Froggy111/ee1111a/pcb/production/bom.csv

Designator | Footprint | Quantity | Value | LCSC Part #
C10, C11, C12, C13, C16, C17, C20, C21, C22, C23, C24, C26, C27, C31, C40, C41, C42, C44, C45, C48, C50, C51, C52, C54, C55, C6, C9 | 0402 | 27 | 100nF 25V | 0402B104K250NT
C14, C32, C36 | CP_Elec_6.3x7.7 | 3 | 220uF 25V
C15, C39, C5, C7 | 0603 | 4 | 1uF 25V | 0603B105M250NT
C18, C19, C2, C25, C28, C29, C30, C33, C35, C37 | 1206 | 10 | 10uF 25V
C34 | 0402 | 1 | 22pF 50V C0G | 0402B104K250NT
C38, C4 | CP_EIA-3216-18_Kemet-A | 2 | 10uF 16V A | CA45-A016K106T
C43, C47, C49 | 0402 | 3 | 2.2uF 6.3V | 0402B104K250NT
C46, C53 | 0402 | 2 | 33pF 50V C0G
D1, D2, D3 | D_SOD-123F | 3 | SMF13CA
D4 | D_SMA | 1 | SS34
D5 | 0402 | 1 | XL-1005SURC | XL-1005SURC
F1, F2 | 1206 | 2 | 4A 15V | BFS1206-4000T/S
FB1, FB2 | 0805 | 2 | 600@100MHz 100m | CBM201209U601T
J1 | AMASS_XT60-M_1x02_P7.20mm_Vertical | 1 | XT60-M
J2 | JST_XH_B4B-XH-A_1x04_P2.50mm_Vertical | 1 | XH_B4B
J3 | Molex_Micro-Fit_3.0_43045-0212_2x01_P3.00mm_Vertical | 1 | 43045-0212
J4 | USB_A_Molex_67643_Horizontal | 1 | USB_A
J5 | PinHeader_1x04_P2.54mm_Vertical | 1 | PinHeader_P2.54_01x04
J6 | USB_C_Receptacle_16P | 1 | USB_C_Receptacle_USB2.0_16P | TYPE-C 16PIN 2MD(073)
L1 | IND-SMD_L13.5-W12.6 | 1 | XR1365-330M
L2 | L_Bourns-SRN6028 | 1 | 3.3uH 4.5A
Q1, Q2, Q3 | SOT-23 | 3 | BSS84K
Q6, Q7 | PDFNWB-8L(3.3x3.3) | 2 | PTQ3060
R1 | 1206 | 1 | 10m 1% 1W
R10, R20, R5 | 0402 | 3 | 36k 5%
R11, R12, R16, R21, R27, R29, R32, R39, R40, R41, R42, R43, R44, R6 | 0402 | 14 | 10k 5%
R13, R14, R2 | 1206 | 3 | 200 1% 250mW | 1206W4F2000T5E
R15, R22, R35, R36, R8 | 0402 | 5 | 2.2k 5%
R17, R18, R19, R3, R4, R7 | 0402 | 6 | 10 5%
R25 | 0402 | 1 | 124k 1%
R26 | 0402 | 1 | 22.1k 1%
R28 | 0402 | 1 | 1kR 1%
R30, R31 | 0402 | 2 | 27 1%
R33, R34 | 0402 | 2 | 1k 1%
R37, R38 | 0402 | 2 | 5.1k 1% | RC-02K512JT
SW1, SW2 | SW_SPST_TS-1088-xR020 | 2 | TS-1088 | TS-1088-AR02016
U1 | SOIC-8_3.9x4.9mm_P1.27mm | 1 | INA219BxD
U2, U5 | Texas_DGN0008G_VSSOP-8-1EP_3x3mm_P0.65mm_EP2x2.94mm_Mask1.846x2.15mm_ThermalVias | 2 | MX27524ES
U3 | SOT-23-5 | 1 | TMI6050-33
U4 | HTSOP-8-1EP_3.9x4.9mm_P1.27mm_EP2.4x3.2mm_ThermalVias | 1 | EA8276P8R
U6 | Winbond_USON-8-1EP_3x2mm_P0.5mm_EP0.2x1.6mm | 1 | W25Q16JVUXIQ
U7 | QFN-56-1EP_7x7mm_P0.4mm_EP3.2x3.2mm | 1 | RP2040
U8 | Diodes_UDFN-10_1x2.5mm_P0.5mm | 1 | ESD73034D-10/TR(ES) | ESD73034D-10/TR(ES)
Y1 | Crystal_SMD_3225-4Pin_3.2x2.5mm | 1 | X322512MSB4SI
