Froggy111/ee1111a/pcb/pcb.kicad_pcb

## KiCad design pcb/pcb.kicad_pcb (2026-10-22)

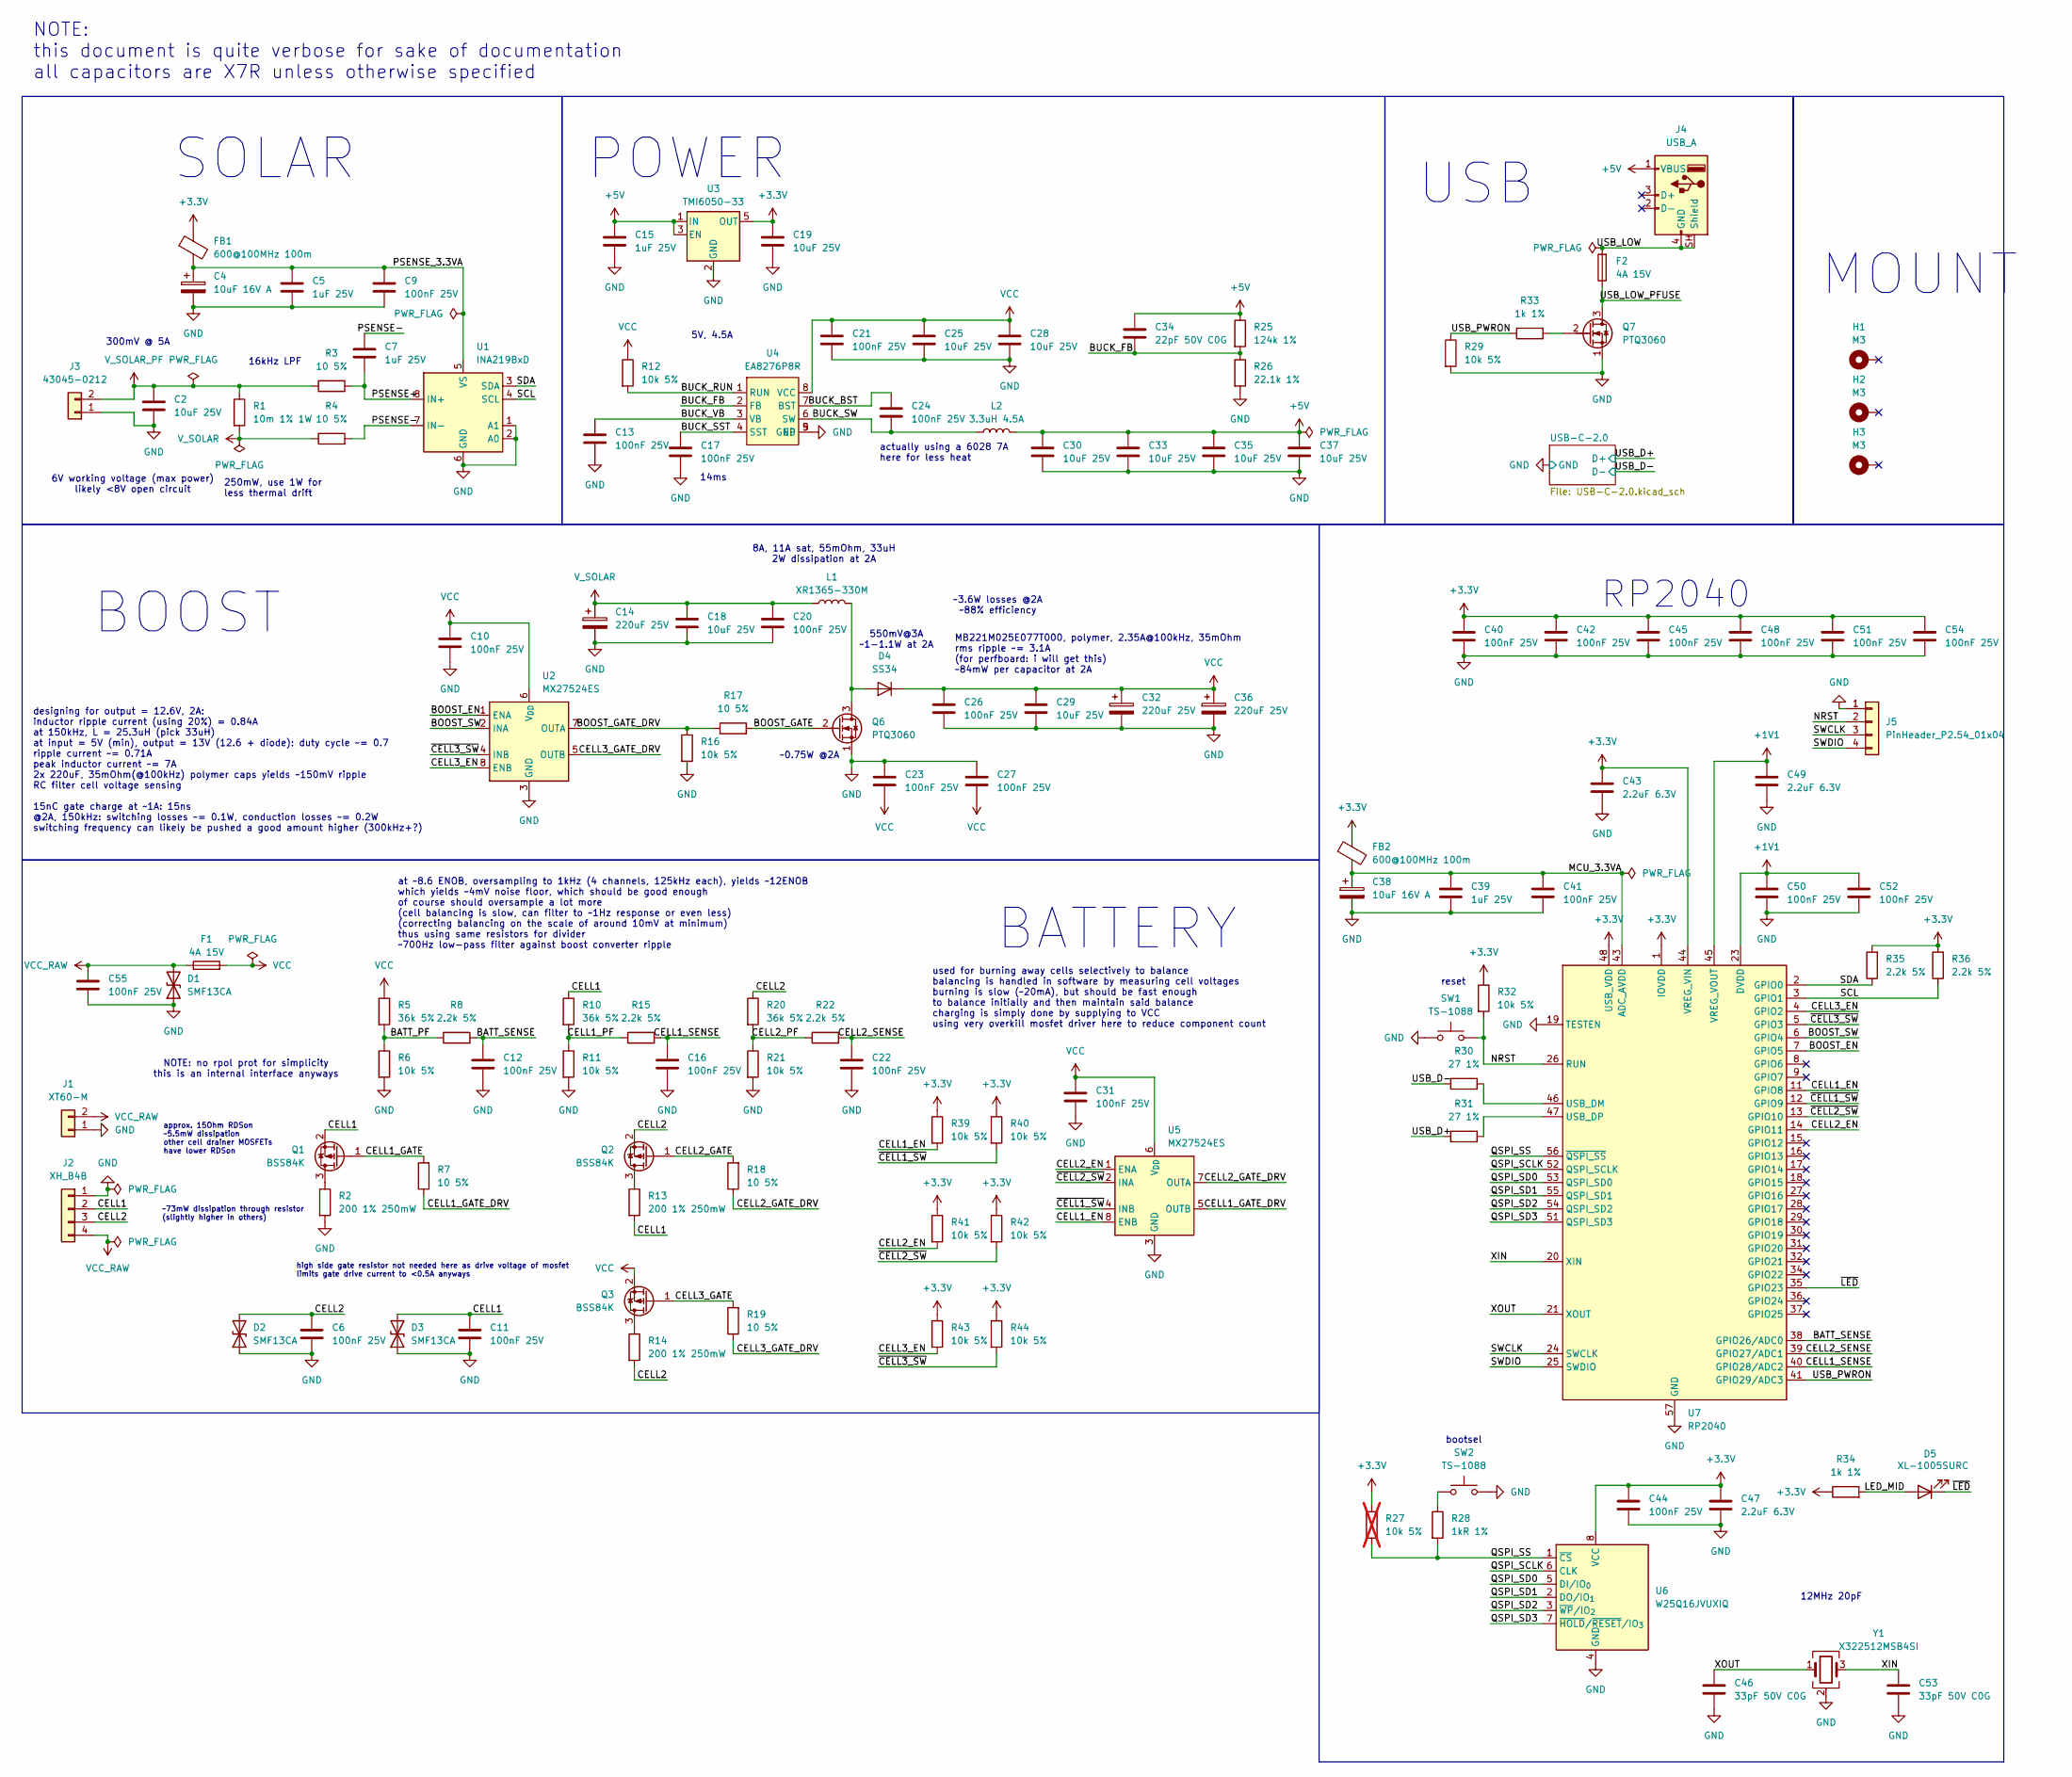
[picture p1: schematic pcb.kicad_sch]

Parts:
C2, C18, C19, C25, C28, C29, C30, C33, C35, C37: 10uF 25V; C_1206_3216Metric
C4, C38: 10uF 16V A; CP_EIA-3216-18_Kemet-A; MPN CA45-A016K106T
C5, C7, C15, C39: 1uF 25V; C_0603_1608Metric; MPN 0603B105M250NT
C6, C9, C10, C11, C12, C13, C16, C17, C20, C21, C22, C23, C24, C26, C27, C31, C40, C41, C42, C44, C45, C48, C50, C51, C52, C54, C55: 100nF 25V; C_0402_1005Metric; MPN 0402B104K250NT
C14, C32, C36: 220uF 25V; CP_Elec_6.3x7.7
C34: 22pF 50V C0G; C_0402_1005Metric; MPN 0402B104K250NT
C43, C47, C49: 2.2uF 6.3V; C_0402_1005Metric; MPN 0402B104K250NT
C46, C53: 33pF 50V C0G; C_0402_1005Metric
D1, D2, D3: SMF13CA; D_SOD-123F
D4: SS34; D_SMA
D5: XL-1005SURC; LED_0402_1005Metric; MPN XL-1005SURC
F1, F2: 4A 15V; Fuse_1206_3216Metric; MPN BFS1206-4000T/S
FB1, FB2: 600@100MHz 100m; L_0805_2012Metric; MPN CBM201209U601T
H1, H2, H3: M3; MountingHole_3.2mm_M3_Pad_Via
J1: XT60-M; AMASS_XT60-M_1x02_P7.20mm_Vertical
J2: XH_B4B; JST_XH_B4B-XH-A_1x04_P2.50mm_Vertical
J3: 43045-0212; Molex_Micro-Fit_3.0_43045-0212_2x01_P3.00mm_Vertical
J4: USB_A; USB_A_Molex_67643_Horizontal
J5: PinHeader_P2.54_01x04; PinHeader_1x04_P2.54mm_Vertical
L1: XR1365-330M; IND-SMD_L13.5-W12.6
L2: 3.3uH 4.5A; L_Bourns-SRN6028
Q1, Q2, Q3: BSS84K; SOT-23
Q6, Q7: PTQ3060; PDFNWB-8L(3.3x3.3)
R1: 10m 1% 1W; R_1206_3216Metric
R2, R13, R14: 200 1% 250mW; R_1206_3216Metric; MPN 1206W4F2000T5E
R3, R4, R7, R17, R18, R19: 10 5%; R_0402_1005Metric
R5, R10, R20: 36k 5%; R_0402_1005Metric
R6, R11, R12, R16, R21, R29, R32, R39, R40, R41, R42, R43, R44: 10k 5%; R_0402_1005Metric
R8, R15, R22, R35, R36: 2.2k 5%; R_0402_1005Metric
R25: 124k 1%; R_0402_1005Metric
R26: 22.1k 1%; R_0402_1005Metric
R27: 10k 5%; R_0402_1005Metric; not fitted
R28: 1kR 1%; R_0402_1005Metric
R30, R31: 27 1%; R_0402_1005Metric
R33, R34: 1k 1%; R_0402_1005Metric
SW1, SW2: TS-1088; SW_SPST_TS-1088-xR020; MPN TS-1088-AR02016
U1: INA219BxD; SOIC-8_3.9x4.9mm_P1.27mm
U2, U5: MX27524ES; Texas_DGN0008G_VSSOP-8-1EP_3x3mm_P0.65mm_EP2x2.94mm_Mask1.8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
U3: TMI6050-33; SOT-23-5
U4: EA8276P8R; HTSOP-8-1EP_3.9x4.9mm_P1.27mm_EP2.4x3.2mm_ThermalVias
U6: W25Q16JVUXIQ; Winbond_USON-8-1EP_3x2mm_P0.5mm_EP0.2x1.6mm
U7: RP2040; QFN-56-1EP_7x7mm_P0.4mm_EP3.2x3.2mm
Y1: X322512MSB4SI; Crystal_SMD_3225-4Pin_3.2x2.5mm

Connections:
+1V1: C49.1, C50.1, C52.1, U7.23 (DVDD), U7.45 (VREG_VOUT), U7.50 (DVDD)
+3.3V: C19.1, C40.1, C42.1, C43.1, C44.1, C45.1, C47.1, C48.1, C51.1, C54.1, FB1.1, FB2.1, R27.1, R32.1, R34.1, R35.2, R36.2, R39.1, R40.1, R41.1, R42.1, R43.1, R44.1, U3.5 (OUT), U6.8 (VCC), U7.1 (IOVDD), U7.10 (IOVDD), U7.22 (IOVDD), U7.33 (IOVDD), U7.42 (IOVDD), U7.44 (VREG_VIN), U7.48 (USB_VDD), U7.49 (IOVDD)
+5V: C15.1, C30.1, C33.1, C34.1, C35.1, C37.1, J4.1 (VBUS), L2.2, R25.1, U3.1 (IN), U3.3 (EN)
/BATT_PF: R5.2, R6.1, R8.1
/BATT_SENSE: C12.1, R8.2, U7.38 (GPIO26/ADC0)
/BOOST_EN: U2.1 (ENA), U7.7 (GPIO5)
/BOOST_GATE: Q6.2 (G), R17.2
/BOOST_GATE_DRV: R16.1, R17.1, U2.7 (OUTA)
/BOOST_SW: U2.2 (INA), U7.6 (GPIO4)
/BUCK_BST: C24.1, U4.7 (BST)
/BUCK_FB: C34.2, R25.2, R26.1, U4.2 (FB)
/BUCK_RUN: R12.2, U4.1 (RUN)
/BUCK_SST: C17.1, U4.4 (SST)
/BUCK_SW: C24.2, L2.1, U4.6 (SW)
/BUCK_VB: C13.1, U4.3 (VB)
/CELL1: C11.1, D3.2 (A2), J2.2, Q1.2 (S), R10.1, R13.2
/CELL1_EN: R39.2, U5.8 (ENB), U7.11 (GPIO8)
/CELL1_GATE: Q1.1 (G), R7.2
/CELL1_GATE_DRV: R7.1, U5.5 (OUTB)
/CELL1_PF: R10.2, R11.1, R15.1
/CELL1_SENSE: C16.1, R15.2, U7.40 (GPIO28/ADC2)
/CELL2: C6.1, D2.2 (A2), J2.3, Q2.2 (S), R14.2, R20.1
/CELL2_EN: R41.2, U5.1 (ENA), U7.14 (GPIO11)
/CELL2_GATE: Q2.1 (G), R18.2
/CELL2_GATE_DRV: R18.1, U5.7 (OUTA)
/CELL2_PF: R20.2, R21.1, R22.1
/CELL2_SENSE: C22.1, R22.2, U7.39 (GPIO27/ADC1)
/CELL3_EN: R43.2, U2.8 (ENB), U7.4 (GPIO2)
/CELL3_GATE: Q3.1 (G), R19.2
/CELL3_GATE_DRV: R19.1, U2.5 (OUTB)
/LED_MID: D5.2 (A), R34.2
/MCU_3.3VA: C38.1, C39.1, C41.1, FB2.2, U7.43 (ADC_AVDD)
/NRST: J5.2, R32.2, SW1.2, U7.26 (RUN)
/PSENSE+: C7.2, R3.2, U1.8 (IN+)
/PSENSE-: C7.1, R4.2, U1.7 (IN-)
/PSENSE_3.3VA: C4.1, C5.1, C9.1, FB1.2, U1.5 (VS)
/QSPI_SCLK: U6.6 (CLK), U7.52 (QSPI_SCLK)
/QSPI_SD0: U6.5 (DI/IO_{0}), U7.53 (QSPI_SD0)
/QSPI_SD1: U6.2 (DO/IO_{1}), U7.55 (QSPI_SD1)
/QSPI_SD2: U6.3 (~WP/IO_{2}), U7.54 (QSPI_SD2)
/QSPI_SD3: U6.7 (~HOLD/~RESET/IO_{3}), U7.51 (QSPI_SD3)
/QSPI_SS: R27.2, R28.2, U6.1 (~CS), U7.56 (~QSPI_SS)
/SCL: R36.1, U1.4 (SCL), U7.3 (GPIO1)
/SDA: R35.1, U1.3 (SDA), U7.2 (GPIO0)
/SWCLK: J5.3, U7.24 (SWCLK)
/SWDIO: J5.4, U7.25 (SWDIO)
/USB_D+: R31.1; also elsewhere on the board
/USB_D-: R30.1; also elsewhere on the board
/USB_LOW: F2.2, J4.4 (GND), J4.SH (Shield)
/USB_LOW_PFUSE: F2.1, Q7.3 (D)
/USB_PWRON: R29.1, R33.1, U7.41 (GPIO29/ADC3)
/XIN: C53.1, U7.20 (XIN), Y1.3
/XOUT: C46.1, U7.21 (XOUT), Y1.1
/~CELL1_SW: R40.2, U5.4 (INB), U7.12 (GPIO9)
/~CELL2_SW: R42.2, U5.2 (INA), U7.13 (GPIO10)
/~CELL3_SW: R44.2, U2.4 (INB), U7.5 (GPIO3)
/~LED: D5.1 (K), U7.35 (GPIO23)
GND: C2.2, C4.2, C5.2, C6.2, C9.2, C10.2, C11.2, C12.2, C13.2, C14.2, C15.2, C16.2, C17.2, C18.2, C19.2, C20.2, C21.2, C22.2, C23.1, C25.2, C26.2, C27.1, C28.2, C29.2, C30.2, C31.2, C32.2, C33.2, C35.2, C36.2, C37.2, C38.2, C39.2, C40.2, C41.2, C42.2, C43.2, C44.2, C45.2, C46.2, C47.2, C48.2, C49.2, C50.2, C51.2, C52.2, C53.2, C54.2, C55.2, D1.1 (A1), D2.1 (A1), D3.1 (A1), J1.1, J2.1, J3.1, J5.1, Q6.1 (S), Q7.1 (S), R2.2, R6.2, R11.2, R16.2, R21.2, R26.2, R29.2, SW1.1, SW2.2, U1.1 (A1), U1.2 (A0), U1.6 (GND), U2.3 (GND), U2.9 (GND), U3.2 (GND), U4.5 (GND), U4.9 (EP), U5.3 (GND), U5.9 (GND), U6.4 (GND), U6.9 (EP), U7.19 (TESTEN), U7.57 (GND), Y1.2 (G), Y1.4 (G); also elsewhere on the board
unnamed: D4.2 (A), L1.2, Q6.3 (D)
unnamed: Q1.3 (D), R2.1
unnamed: Q2.3 (D), R13.1
unnamed: Q3.3 (D), R14.1
unnamed: Q7.2 (G), R33.2
unnamed: R28.1, SW2.1
unnamed: R30.2, U7.46 (USB_DM)
unnamed: R31.2, U7.47 (USB_DP)
VCC: C10.1, C21.1, C23.2, C25.1, C26.1, C27.2, C28.1, C29.1, C31.1, C32.1, C36.1, D4.1 (K), F1.2, Q3.2 (S), R5.1, R12.1, U2.6 (V_{DD}), U4.8 (VCC), U5.6 (V_{DD})
VCC_RAW: C55.1, D1.2 (A2), F1.1, J1.2, J2.4
V_SOLAR: C14.1, C18.1, C20.1, L1.1, R1.2, R4.1
V_SOLAR_PF: C2.1, J3.2, R1.1, R3.1

Notes on the sheet:
actually using a 6028 7A here for less heat
~73mW dissipation through resistor (slightly higher in others)
POWER
300mV @ 5A
designing for output = 12.6V, 2A: inductor ripple current (using 20%) = 0.84A at 150kHz, L = 25.3uH (pick 33uH) at input = 5V (min), output = 13V (12.6 + diode): duty cycle ~= 0.7 ripple current ~= 0.71A peak inductor current ~= 7A 2x 220uF, 35mOhm(@100kHz) polymer caps yields ~150mV ripple RC filt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
NOTE: this document is quite verbose for sake of documentation all capacitors are X7R unless otherwise specified
SOLAR
14ms
~3.6W losses @2A ~88% efficiency
12MHz 20pF
NOTE: no rpol prot for simplicity this is an internal interface anyways
at ~8.6 ENOB, oversampling to 1kHz (4 channels, 125kHz each), yields ~12ENOB which yields ~4mV noise floor, which should be good enough of course should oversample a lot more (cell balancing is slow, can filter to ~1Hz response or even less) (correcting balancing on the scale of around 10mV at mini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
~0.75W @2A
16kHz LPF
250mW, use 1W for less thermal drift
RP2040
MOUNT
550mV@3A ~1-1.1W at 2A
6V working voltage (max power) likely <8V open circuit
8A, 11A sat, 55mOhm, 33uH 2W dissipation at 2A
BOOST
MB221M025E077T000, polymer, 2.35A@100kHz, 35mOhm rms ripple ~= 3.1A (for perfboard: i will get this) ~84mW per capacitor at 2A
5V, 4.5A
reset
approx. 15Ohm RDSon ~5.5mW dissipation other cell drainer MOSFETs have lower RDSon
high side gate resistor not needed here as drive voltage of mosfet limits gate drive current to <0.5A anyways
bootsel
BATTERY
USB
used for burning away cells selectively to balance balancing is handled in software by measuring cell voltages burning is slow (~20mA), but should be fast enough to balance initially and then maintain said balance charging is simply done by supplying to VCC using very overkill mosfet driver here to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

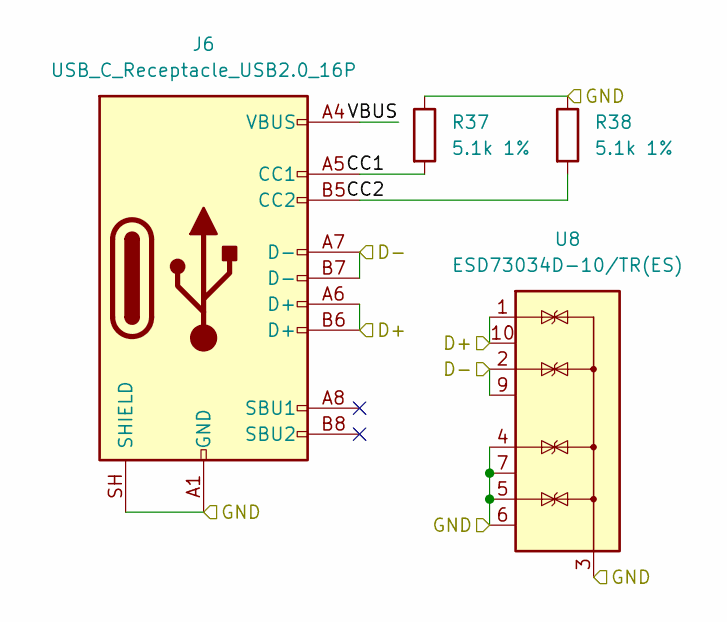
[picture p2: schematic USB-C-2.0.kicad_sch]

Parts:
J6: USB_C_Receptacle_USB2.0_16P; USB_C_Receptacle_16P; MPN TYPE-C 16PIN 2MD(073)
R37, R38: 5.1k 1%; R_0402_1005Metric; MPN RC-02K512JT
U8: ESD73034D-10/TR(ES); Diodes_UDFN-10_1x2.5mm_P0.5mm; MPN ESD73034D-10/TR(ES)

Connections:
/USB-C-2.0/CC1: J6.A5 (CC1), R37.2
/USB-C-2.0/CC2: J6.B5 (CC2), R38.2
/USB-C-2.0/VBUS: J6.A4 (VBUS), J6.A9 (VBUS), J6.B4 (VBUS), J6.B9 (VBUS)
/USB_D+: J6.A6 (D+), J6.B6 (D+), U8.1 (IO1), U8.10 (NC); also elsewhere on the board
/USB_D-: J6.A7 (D-), J6.B7 (D-), U8.2 (IO2), U8.9 (NC); also elsewhere on the board
GND: J6.A1 (GND), J6.A12 (GND), J6.B1 (GND), J6.B12 (GND), J6.SH (SHIELD), R37.1, R38.1, U8.3 (G), U8.4 (IO3), U8.5 (IO4), U8.6 (NC), U8.7 (NC), U8.8 (G); also elsewhere on the board

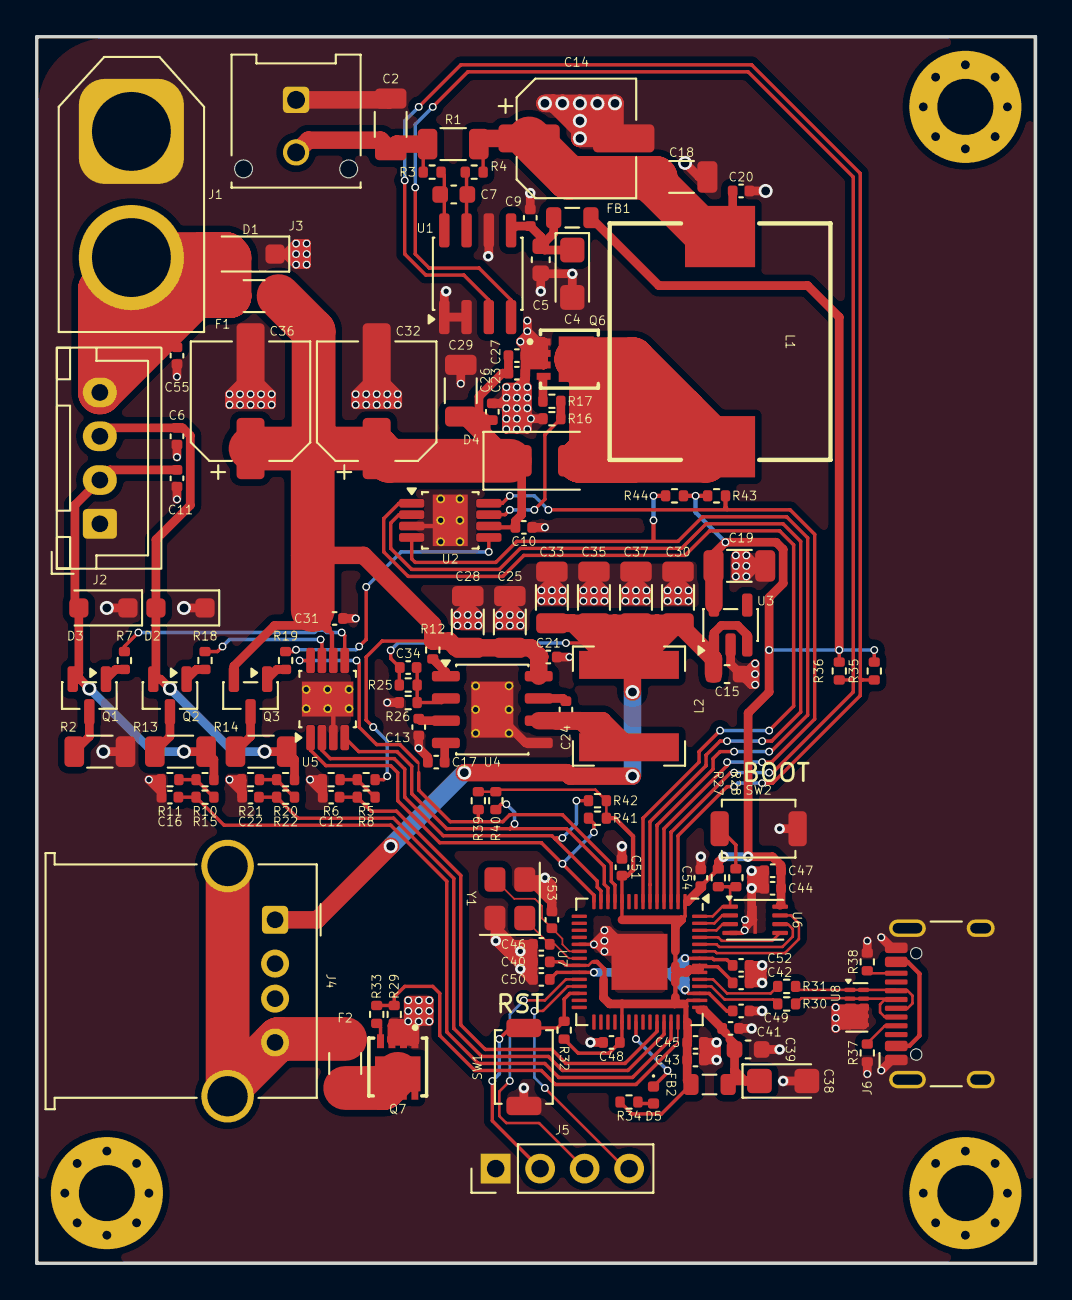
[picture p3: board pcb.kicad_pcb from above]

Board: 2 copper layers, 57.0 x 70.0 mm, 129 parts (0 on the bottom side), 73 nets.
