Froggy111/ee1111a/firmware/src/types.hpp

#pragma once
#include <cstdint>

namespace types {
using u8 = uint8_t;
using u16 = uint16_t;
using u32 = uint32_t;
using uint = unsigned int;
using i8 = int8_t;
using i16 = int16_t;
using i32 = int32_t;
}  // namespace types
