Froggy111/ee1111a/(commit log)

2026-10-21 pcb components
    [USB-C-2.0.kicad_sch, pcb.kicad_pcb, pcb.kicad_sch]
2026-10-21 fixed schematic
    [USB-C-2.0.kicad_sch, pcb.kicad_pcb, pcb.kicad_sch]
2026-10-22 pcb done
    [bom.csv, designators.csv, pcb.kicad_pcb, pcb.kicad_sch, positions.csv]
2026-10-22 fixed some issues
    [bom.csv, designators.csv, pcb.kicad_pcb, pcb.kicad_sch, positions.csv]
